SMILE-tool-box/EricaNext/calib/cad/SM3_Inner_3atm.step

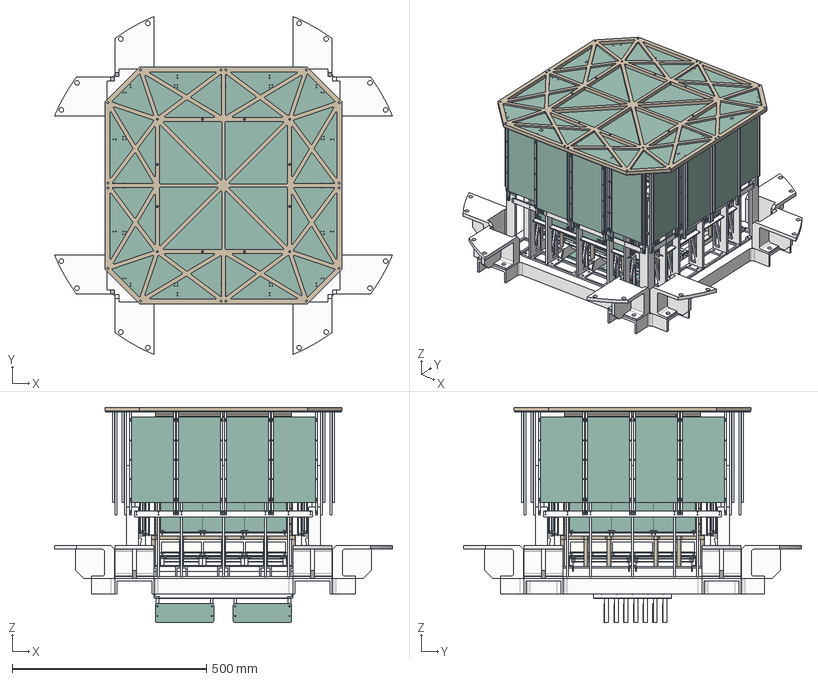
[picture p1: CAD file, 2026-11-06]
calib/cad/SM3_Inner_3atm.step
869.2 x 869.2 x 554.1 mm
jig_a x 36
Amp x 18
ADC x 18
frame x 18
MPPC_RCchain x 108
FPGA x 18
jig_b x 36
GSO_26mm x 36
cage_jig x 18
BJ_beam_b x 4
BJ_beam_a x 3
BJ_beam_c x 2
SJ_beam_a x 8
GSO_13mm x 72
SJ_post x 20
SJ_beam_b x 4
SJ_bottom x 4
SJ_post_E x 4
TCU_FPGA
TCU_IF x 14
TCU_beam1 x 2
TGV uPIC
Drift_GEM_0
Drift_GEM_1
offset_jig
SideBottom_elec x 4
SideTop_elec x 4
Drift_Top
TPC_Top
SM3_3atm_igeta
