SMILE-tool-box/EricaNext/(commit log)

2026-06-25 test3.pyとplot_track3d.pyを追加
2026-06-26 modulesを変更、枚数変更に対応
2026-11-04 ReadData: merged event ID, board time words, all encoder records; CalcFADC: per-board spectra (Save_board_plots); add RawTreeWriter_sm3
2026-11-04 Config-driven chain like EricaNext_try: config/*.json, run_chain.py, run_runs.sh, build_ericanext.sh; ignore data and caches
2026-11-05 PSA modules for the SMILE-3 scintillator: PSA_ReadData, PSA_CalcFADC, PSA_CenterGravity, PSA_Calibration, PSA_TreeWriter
    - smile3_psa.json: the chain of psa_decode.py + pixel_id.py (analysis_sm3_FM/PSA_analysis); output tree PSA_TreeWriter/psa
    - PSA_ReadData merges the HA boards by the trigger counter, or follows ReadData (sync_tpc); extra_data_dirs for the other storage
    - calib/psa: psa_param_20261029.csv and position_haNN.csv (peak_runs_run01-11, n,m added by run_script/psa_position_nm.py)
    - run_chain.py --data-dir also sets PSA_ReadData.data_dir
    - Checked against psa_decode.py + RBFInterpolator: 20261029_run06 (ha03), 20261102_run02 HA_cal (ha00, ha06),
    identical hits, peak_id, saturati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
2026-11-05 PSA_Event: PSA hits in detector coordinates for Reconstruct; AGENTS.md (handover)
    - PSA_Event: absorption point from the pixel and calib/psa/geometry.csv (format in geometry_template.csv,
    values not decided yet), event selections PSA_SingleHit / PSA_MultiHit / PSA_NoHits
    - Reconstruct uses PSA_Event when it is in the chain, else HA_Calc; single_hit has evt_id (trigger counter)
    - smile3_reconstruct_psa.json: ReadData -> CalcFADC -> TPC_Calibration -> PSA_* -> PSA_Event -> Reconstruct
    - scripts/check/compare_psa_python.py: hit-by-hit comparison with psa_decode.py + pixel_id.py
    - Checked on ETCC 20261102_run04 with dummy energy and geometry files (not committed): Eg and Pg of all
    20 single_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
2026-11-05 PSA calibration files made by scripts (position, temperature gain, energy) and read by the chain; PSA module tutorials
    - PSA_Calibration: temp_gain_haNN.csv (ch,temp,gain; linear between rows) -> hg_corr = hg / gain(T),
    energy = p0 + p1 hg_corr; PixelHG and the new tree branch hg_corr use it; csv comment lines (#) allowed
    - scripts/calib/make_psa_position.py (peak finder of peak_search.py, same 64 peaks on the same histogram),
    make_psa_temp_gain.py (photopeak per temperature bin as temp_spectra.py), make_psa_energy.py (per pixel,
    one or more lines); they sum any number of smile3_psa outputs and write QA figures to <out>/qa/
    - tutorials/1_DataIO/modules: PSA_ReadData, PSA_CalcFADC, PSA_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
2026-11-05 PSA calibration from the UVSOR data: grid peak finder, run12 position, Cs temperature gain and 662 keV energy
    - make_psa_position.py --method grid (default): 8 columns from the x projection, 8 rows per column from
    the second derivative of the y projection (the outer rows of the central columns are shoulders);
    localmax (= peak_search.py) took several maxima in the long central spots and lost the outer columns.
    --min-frac drops a ch whose corrected hits are not in 8x8 (ha01 ch4).
    - PSA_ReadData merges the files of a board from several directories by number; recursive scans
    subdirectories (part0..part4 of 20261103_run12; identical copies in killua part0/part2 are used once)
    - calib/psa: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
2026-11-06 CalcFADC: do not skip events (flags FADC_NoHit, FADC_1Hit); TPC_Calibration: TPC_Ee_Valid, sum of anode charges without a gain map
    - CalcFADC returned AS_SKIP for FADC_NoHit, and as the cathode was searched only when one anode
    channel had charge, events with two or more anode channels (29 % of the 2026-06-23 TPC_cal) were
    dropped from TPC_Calibration, TOT_Skewness and Reconstruct. SMILE_tool_box CalcFADC::Process() and
    EricaNext_try skip only when the anode/cathode data is missing; now the same, with flags only.
    The 1-hit spectra (Spec1Hit) keep their condition (one anode and one cathode channel).
    - TPC_Calibration with NoCalData: Energy += charge (was =, the last anode channel only)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
2026-11-06 TPC_Calibration: FADC channel = strip / 32 (4 board + ch), fixed 48 x 48
    The channel of a strip was strip / (1536 / (4 x boards present)): with a missing board (c01 of
    run_20260623T072649Z, 44 cathode channels) it was strip / 34, the wrong channel, and out of the
    HitPanel range for cathode strips >= 1496 (std::out_of_range, seen once CalcFADC no longer skips).
    Now the index of CalcFADC's charges (4 board + ch, 0-47) for HitPanel and the gain map (i j Ka Kb);
    gain-map lines out of range are ignored. Without a gain map the energy is unchanged (anode side).
    2026-06-23 TPC_cal, all 101974 events: runs through; TPC_Ee_Valid 67506.
2026-11-06 TPC module tutorials: ReadData, CalcFADC, TPC_Calibration, TOT_Skewness, Reconstruct, RawTreeWriter_sm3
    - 2026-06-23 TPC_cal (test.data/run_20260623T072649Z, first 50000 events) for the TPC modules,
    the ETCC 20261102_run04 with example PSA values for Reconstruct
    - CalcFADC: charges recomputed from RawTreeWriter_sm3 reproduce CalcFADC/ChargeAnode bin by bin
    (summed in the same order as the C++: samples at exactly baseline + 20 ADU are common)
    - coincidences drawn in the detector coordinates of 0_Introduction (same as TOT_Skewness Get_TPC_XYZ)
    - PSA_Event and Reconstruct notebooks re-run after the CalcFADC change
    - AGENTS.md: known TPC issues not fixed yet (Ve not a unit vector, panel thre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
2026-11-06 Config names, PSA temperature reference, calib/tpc
    - smile3_reconstruct_psa.json -> smile3_reconstruct.json.
    - smile3_tot_skewness.json becomes smile3_tpc_only.json (ReadData ->
    CalcFADC -> TPC_Calibration -> TOT_Skewness, with the full ReadData and
    CalcFADC parameter docs of the old smile3_tpc_only). Same output as the
    old smile3_tot_skewness (2000 events, every tree and histogram).
    - PSA_Calibration: remove temp_coef / temp_ref. The reference temperature
    (gain = 1) is in temp_gain_haNN.csv; a board without the table is not
    corrected (hg_corr = hg) and a warning says so.
    - Remove run_script/test2.py, test3.py and run_all.sh (which only ran
    test3.py; run_runs.sh does the same wit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
2026-11-06 CalcFADC computes charges only; 1-hit spectra in post-analysis; butterfly map
    - CalcFADC: remove save_TH_plots / save_board_plots and their histograms
    (baseline, charge, channel and board 1-hit spectra) and the unused evs
    FADC_1Hit / FADC_NoHit. It only computes the charges for TPC_Calibration.
    - scripts/calib/make_tpc_spec1hit.py: the same histograms from the raw data
    tree (smile3_raw), with the CalcFADC charge computed in the same C++ order,
    plus qa/<name>_board.png. On the 2026-06-23 TPC_cal run it reproduces all
    808 non-empty histograms of the former CalcFADC (50000 events) bin by bin.
    - 7_CalcFADC tutorial uses the script; all TPC tutorials re-executed.
    - smile3_tpc_only (2000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
2026-11-06 TOT_Skewness: SMILE-3 GEM position, drift velocity file, SMILE-2+ typical values with a warning
    - z = v (clock - clock_offset) + z_gem_mm: the GEM plane is now a parameter,
    10 mm for SMILE-3 (SMILE-2+: 27 mm hard-coded before).
    - drift_velocity_file (calib/tpc/drift_velocity.dat: lines 'clock_offset'
    and 'velocity'). Without it the config values are used and a warning says
    that a SMILE-3 drift velocity calibration is needed.
    - Config values: SMILE-2+ typical (2019-07-01 Per02/Per03 drift_velocity.dat:
    offset 85 clock, mean 0.383 mm/clock) instead of the SMILE_tool_box
    constructor defaults 90 / 0.5. SMILE-3 drift length (uPIC - top plate)
    317 mm is recorded in the docs for the fut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
2026-11-06 scripts/calib/make_tpc_drift_velocity.py: drift velocity file from the raw data tree
    Same method as EricaNext_try DriftVelocity (edges of the hit clock
    distribution from its derivative; the top edge by a Gaussian fit),
    one value for the run, written as the lines read by TOT_Skewness.
    The file is written only if the box shape checks pass, with a QA
    figure. On SMILE-2+ Per02 it gives clock_offset 85 and 0.3844 mm/clock
    (EricaNext_try: 85, 0.383-0.384); the 2026-06-23 SMILE-3 TPC_cal is
    rejected (no top edge). No SMILE-3 file yet.
2026-11-06 0_Introduction section 6: FM PSA file names ha<NN>_<n>.dat, PSA_* modules do the analysis
    The board row described the file names of the earlier Kyoto/Yamagata tests
    (<date>_<time>_<FPGA_SN>_<n>.dat). FM: ha<NN>_<n>.dat, 14 boards, split over
    the two storage nodes; HA <-> FPGA SN in calib/psa/psa_param.csv. The
    example cell still reads the Yamagata test data and now says so.
2026-11-06 0_Introduction: board table reads the 2026-06-23 run directly (no config warning), clearer output
2026-11-06 calib/psa/geometry.csv from the CAD STEP file (scripts/calib/make_psa_geometry.py)
    - scripts/calib/step_reader.py: reads the STEP assembly tree without a CAD
    library (NAUO / context dependent shape representations, B-rep vertices).
    - make_psa_geometry.py: block centres and the pixel pitch (5.96 mm, from the
    grooves) of the GSO_26mm / GSO_13mm blocks of SM3_Inner_3atm.step,
    X = y_CAD, Y = x_CAD, Z = 427.04 - z_CAD (lower face of the uPIC board;
    GEM at Z = 10.0 mm, top plate at 317.0 mm in the CAD). HA number, ch order
    and pixel directions from the HA layout figure (table HA_LAYOUT).
    - geometry.csv: 18 HA x 6 ch; all corner pixels lie inside their block.
    smile3_reconstruct on 20261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
2026-11-06 Add the CAD STEP file (calib/cad/SM3_Inner_3atm.step) and make geometry.csv from it
    Same geometry values as before; only the input path in the header changes.
2026-11-06 ReadData: extra_data_dirs (and run_chain.py --extra-data-dir) to read a run split over the two storage nodes
    Each encoder board is read from the first of data_dir, extra_data_dirs
    that has its first file (a warning if it is in two). run_chain.py
    --extra-data-dir adds the directory to ReadData and PSA_ReadData. On
    20261102_run04 (calltt + killua) the output is identical to reading the
    directory of symbolic links. Tutorials 10/11 use the two directories;
    all module tutorials re-executed.
2026-11-06 PSA energy calibration from Cs-137 662 keV and Co-60 1173/1332 keV per pixel
    make_psa_energy.py: --cs / --co instead of --line. Fits as energy_calib.py
    (analysis_sm3_FM): Gaussian + line for Cs, two constrained Gaussians for the
    unresolved Co doublet, hg_corr = a E + b to the 3 points (p0 free). Only hits
    inside the temperature range of the temp_gain table are used. Pixels without
    a usable Co fit take p0 of the ch sum and p1 from their Cs line; channels whose
    ch-sum Co fit fails the checks use Cs only (p0 = 0). Bad rows are not written.
    calib/psa/energy_haNN.csv remade for 13 boards; tutorial and docs updated.
2026-11-08 AGENTS.md: the energy calibration should depend on the temperature (needs runs of two sources over a wide temperature range)
2026-11-08 Reconstruct: geometric alpha and incident direction from the TOT_Skewness track
    Same formulas as SMILE_tool_box Erica/Reconstruct (TRA, SingleHit) and SMLib
    Compton_common: Vg = Pg - Pe, cos_alpha_geo = Vg . Ve (Ve made a unit vector
    here), incident direction (recon_vector), and with source_position also ARM
    and SPD. has_track flags events with TOT_Ve_TRA; otherwise 0xffffffff.
    smile3_reconstruct runs TOT_Skewness just before Reconstruct (it skips events
    without anode or cathode hits). Tutorial 11_Reconstruct uses calib/psa.
2026-11-08 PSA_Event tutorial: rerun with geometry.csv from CAD and the Cs + Co energy calibration
2026-11-12 Add TPC calibration tutorials and move reader plotting to post-analysis
2026-11-13 Tutorials: explicit absolute input/output paths; drift velocity: fit both edges
    Tutorials
    - Every notebook has an "input and output" cell at the top with absolute paths.
    Data and outputs are large, so they live outside the repository (NAS etc.).
    Paths that depend on the environment are "<書き換え>" and stop the notebook
    until they are set. tutorials/cache, the SMILE3_* environment variables and
    test.data defaults are removed. README updated.
    scripts/calib/make_tpc_drift_velocity.py
    - clock_offset (GEM side edge) is a Gaussian fit of the derivative peak in the
    clock of the largest derivative +- --gem-window (default 40) instead of the
    bare maximum, which jumped with the noise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
2026-11-13 ReadData: make Track_A/C only when a module asks; environment check script
    - ReadData: Track_A/C (strip x clock TH2C of the event) are made and filled from
    the hit lists the first time Get_Track_A/C is called. A chain that only writes
    the raw tree (smile3_raw) no longer makes, resets or fills them. They are
    still not written to the ROOT file.
    - scripts/env/check_environment.py: preliminary check of the build, chain and
    notebook environment (tools, Python headers, ANLNext/EricaPy import, PyROOT,
    numpy, scipy, matplotlib, Jupyter). --mode build/run/notebook/all,
    --python for the chain, --analysis-python for the notebooks. Standard library
    only; reads no data and installs nothing.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
